yongyaoduan/comp5047-campfire-aftercare/README.md

# Campfire Aftercare — COMP5047 Group 23

Raspberry Pi vision and Bluetooth LE, FireBeetle ESP32-E two-LED control, spoken prompts, water/heat sensors, and a 12V water pump.

## Lights and speech

| Output | Meaning |
|---|---|
| Green / GPIO16 | Person detected |
| Red / GPIO17 | Fire: object temperature at least 10°C above room temperature for 1 s; off once below room + 7°C for 1 s |
| Audio / GPIO25 DAC1 | Spoken prompts and alarm |
| Pump / GPIO26 | MOSFET control signal |

**Both LEDs continue to indicate their states while spraying.** There is no LED for the heart or for a low tank: a held heart is answered by "I love you too" and, when the bowl is hot, by water; a low tank is announced by the repeating water prompt.

The committed English WAV files and flash-resident samples are generated with macOS Samantha at 100 words/minute, then high-passed, compressed to full DAC swing and played 5% slower (15.2 kHz) for a calm, loud voice (`firebeetle/audio/build_audio.py`):

- [I need some water.](firebeetle/audio/water.wav) — repeats every 5 seconds while the tank is low (fewer than the bottom 5 of the sensor's 20 sections wet, under about 25 mm) and someone is in view. A low tank does not block the pump.
- [Fire's still burning. Make a heart, I'll put it out.](firebeetle/audio/fire.wav) — once, when someone comes back during the alarm or an automatic spray.
- [I love you too.](firebeetle/audio/love.wav) — once per new heart gesture.
- [Putting the fire out.](firebeetle/audio/spray.wav) — once, when an automatic spray starts.
- [Enough water, thank you.](firebeetle/audio/full.wav) — once, when the bottom 15 of the sensor's 20 sections (75 mm) are wet, leaving headroom below the top of the 4 L tank; it can repeat only after the level has dropped below 13 sections.

Playback is offline. The WAV files and generated `AudioSamples.h` are included; macOS is needed only to regenerate them. Audio runs through I2S DMA on GPIO25 in its own task, independently of the control loop and sensor reads. An alarm interrupts speech. A due low-water warning takes priority over another spoken prompt.

## Control sequence

1. No fire: no sound, no pump; timers reset. A heart still plays "I love you too".
2. Fire with people in view is normal use: no sound, no pump.
3. **A heart works at any time.** While any visible person holds a two-hand heart and the bowl is hot, the pump runs; it stops the moment the hands drop (the BLE heart message expires 0.8 s after the last heartbeat; with the Pi 3B+ at ~1 FPS the observed stop is about 2 s after the hands actually drop).
4. Fire with nobody in view (including nobody ever seen): wait 5 s silently (shortened for the demo; a field version would wait longer). Coming back within 5 s: nothing happens.
5. Then alarm 1 s on / 1 s off, three times before the automatic spray (at most 10 bursts per episode, see step 7). Coming back during the alarm stops it and plays the fire prompt once; after that it is normal use.
6. Nobody back after the third pause (11 s from absence): "Putting the fire out", then spray until the bowl falls below room + 7°C. A person walking in without a heart stops the pump immediately.
7. Low water (fewer than 5 sections) is only spoken: with someone in view it asks for water, and the pump keeps working while any water is detected. Only an empty tank (no wet section) blocks every spray; with nobody in view the alarm then keeps calling, up to 10 bursts in all, and the automatic spray starts once water is added.
8. Re-ignition after an automatic spray restarts the cycle at step 4. Invalid/stale sensor readings, BLE disconnect, stale command stream, or STOP block spraying and reset the sequence.

Room temperature is the mean IR object reading over the first 10 s after power-up (restarted if the readings spread by more than 2°C), so keep anything warm away from the IR window at start-up. Fire detection uses hysteresis (on at room + 10°C, off below room + 7°C, each held for 1 s) so the pump does not chatter around one threshold. **Start-up standby:** for about 10 s the station does nothing and both LEDs blink; once the thermometer is calibrated and the water sensor answers, the blinking stops. Put the water-level sensor in the tank only after the blinking stops. A fast-flickering red LED after 30 s means a sensor is not answering. The Pi always looks for at least four hands, so any visible person's heart counts even with `--max-people 1`.

Temperature and water are sampled in a separate task roughly every 250 ms, so cooling is checked more frequently than the report's 5-second requirement. The water threshold is the reference raw value >100; two valid samples settle wet/dry. Isolated upper drops are ignored for height, but a film on the bottom segment can still look like water. Water-height precision is not 100 ms: that is a diagnostic polling interval, not measurement accuracy.

## Circuit

The report's existing drawing and visual layout are included unchanged:

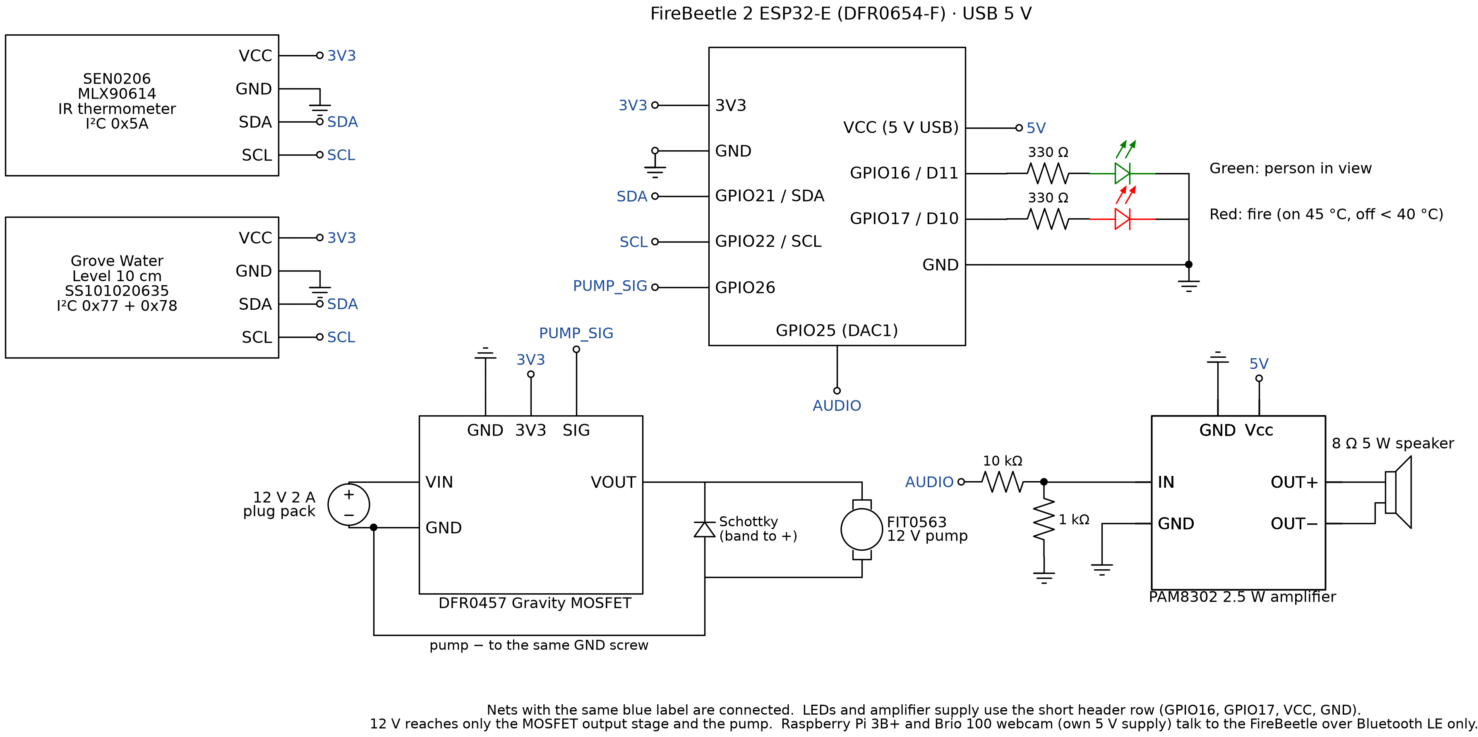
[picture p1: img/schematic.png]
Circuit schematic


[SVG schematic](img/schematic.svg) · [System diagram](img/circuit.svg) · [Drawing source](schematic.py)

| Connection | Wiring |
|---|---|
| Each LED | GPIO16 (green) / GPIO17 (red), on the short header row → its own 330Ω resistor → anode; cathode → GND on the same row |
| Water sensor | White SDA→21, yellow SCL→22, red→3V3, black→GND |
| IR thermometer | SDA→21, SCL→22, VCC→3V3, GND→GND; use module labels |
| DFR0457 control plug | Signal→26, VCC→3V3, GND→GND |
| DFR0457 screw terminals | Supply +12V→VIN; supply negative and pump negative→GND; pump positive→VOUT |
| Flyback diode | Across pump; striped cathode→pump positive, anode→pump negative |
| Makerverse CE08263 audio | GPIO25→10kΩ→IN; IN→1kΩ→GND; both amplifier GND pins→board GND; SD left open |
| Amplifier supply | Board VCC (5V from USB) and GND on the short header row; begin at low volume |
| Speaker | Both leads to amplifier output +/−; neither lead to GND |

The drawing uses functional input/output labels rather than literal terminal counts. The actual DFR0457 has three power screw terminals, **VIN/GND/VOUT**. Makerverse CE08263 has **IN, signal GND, SD, Vcc, power GND**; its signal GND corresponds to the drawing's grounded input reference. Match the labels on the actual modules.

12V powers only the pump circuit; never connect it to the FireBeetle, Pi or amplifier. The Pi/webcam use their own 5V supply; FireBeetle uses USB power. Keep the existing sensor and pump wires. GPIO25 is reserved for audio.

## Repository layout

- `pi/`: USB camera processing, person/heart recognition, latest-frame capture and BLE client.
- `firebeetle/`: two-LED/voice firmware, state machine, sensor readers, audio clips and C++ tests.
- `mac-backup/`: demo-day fallback — Swift/Apple Vision app for a MacBook that replaces the Pi's vision step and sends the same BLE commands (see `mac-backup/README.md`).
- `hardware-tests/`: standalone diagnostic programs, including 100 ms raw water logging.
- `cad/`: enclosure source scripts and schedules.
- `schematic.py`, `img/`: report circuit diagram and generator.

CAD files are historical design iterations, not an endorsement of every part as fabrication-ready; the older full-print bracket alignment issue is recorded in `cad/campfire-simple-v3/ASSEMBLY_STATUS.txt`. Downloaded model weights and build caches are excluded. Some optional photo/benchmark scripts need locally supplied inputs.

## Raspberry Pi setup

Tested dependency target: Pi 3B+, 64-bit OS, Python 3.11.

```bash
cd pi
python3.11 -m venv .venv
source .venv/bin/activate
python -m pip install -r requirements-pi3.txt
python download_models.py
python app.py --profile pi3 --max-people 1
```

Model downloads are versioned and SHA-256 checked. The USB webcam must be connected to the Pi. The BLE peripheral advertises `Campfire-FireBeetle`. Inference speed and supply stability must be checked on the actual Pi; simulation tests do not verify live camera or BLE operation.

### Start on boot

`pi/campfire.service` is a systemd user service (no sudo needed). On the Pi: `mkdir -p ~/.config/systemd/user && cp ~/gesture-pump/campfire.service ~/.config/systemd/user/`, `loginctl enable-linger "$USER"`, then `systemctl --user daemon-reload && systemctl --user enable --now campfire`. It runs `app.py --profile pi3 --max-people 1` about 20 s after every power-up and restarts it if it stops (`journalctl --user -u campfire -f` for logs; `systemctl --user stop campfire` before a manual run).

## FireBeetle build and upload

Install PlatformIO, connect FireBeetle 2 ESP32-E, then:

```bash
pio run -d firebeetle
pio device list
pio run -d firebeetle -t upload --upload-port YOUR_SERIAL_PORT
pio device monitor --port YOUR_SERIAL_PORT --baud 115200
```

BLE accepts raw one-byte values: `0` absent, `1` present, `4` heart held, `5` heart released, `6` STOP. USB serial accepts those ASCII digits. USB commands expire unless refreshed; the Pi refreshes commands automatically. Serial `w`, `f`, `l`, `p` tests the four voice clips without intentionally enabling the pump.

The physical pump requires a MOSFET module and independent 12V supply. Diagnostic GPIO26 blink/wiring programs can activate the attached pump; use the appropriate firmware for the connected hardware.

## Tests

```bash
(cd pi && python3 -m unittest discover -s tests -p 'test_*.py')
c++ -std=c++11 firebeetle/tests/control_test.cpp -o /tmp/campfire-control-test
/tmp/campfire-control-test
pio run -d firebeetle
```

Tests cover LED states during pumping, heart-held spraying, absent-person timing, return cancellation, dry/unknown-water lockout, cooling, communication loss, time wraparound, and camera/gesture policies. They do not constitute a physical water-flow, acoustic clarity, or end-to-end hardware test. This two-LED/voice build has been compiled and simulation-tested, and has not been uploaded to the physical board in this session.

## Regenerate diagrams or speech

```bash
python3 -m pip install -r requirements-diagram.txt
python3 schematic.py
# macOS only; bundled WAV/header files are already usable elsewhere:
python3 firebeetle/audio/build_audio.py
```

The generator writes beside itself regardless of the current working directory. The original report file is not modified.

## References

[FireBeetle](https://wiki.dfrobot.com/dfr0654/) · [MOSFET](https://wiki.dfrobot.com/dfr0457) · [Makerverse amplifier](https://core-electronics.com.au/makerverse-pam8302-2-5w-mono-amplifier.html) · [Water sensor](https://wiki.seeedstudio.com/Grove-Water-Level-Sensor/)

This is a supervised classroom prototype, not a validated fire-extinguishing device.

## Water level sensor: power up dry

The Grove water-level sensor calibrates itself when it is powered. Powered up while
its pads are in water, it reports every pad as 0 (I²C still works), so the station
believes the tank is empty and keeps asking for water. Always power the station with
the sensor out of the water (or before filling), then fill. If it restarted in water:
unplug the 12 V pump, lift the sensor out, wipe it, power-cycle, put it back.
The firmware treats a sudden drop from a real level to all-zero as a sensor fault
(no water request, no spray) until real readings return; serial `r` prints the pads.
