yongyaoduan/comp5047-campfire-aftercare/cad/blender-built-enclosure/renders_woodwork_and_leaf.png

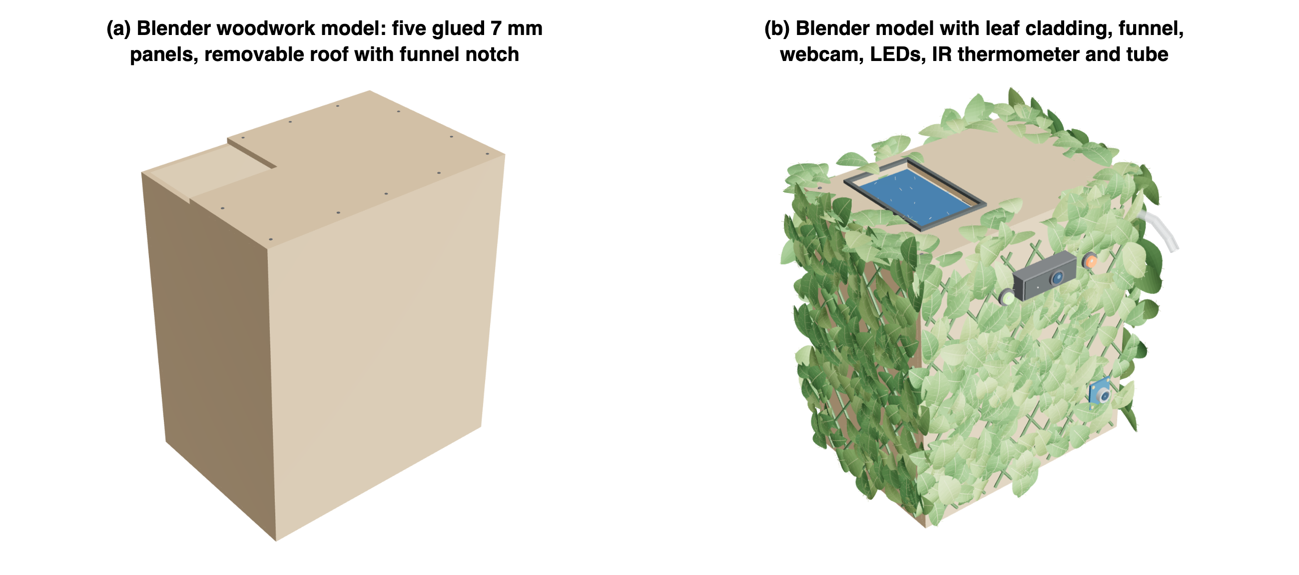
cad/blender-built-enclosure/renders_woodwork_and_leaf.png
