yongyaoduan/comp5047-campfire-aftercare/cad/campfire-simple-v3/parts.csv

name | quantity | x | y | z | volume_cm3
base_1 | 1 | 165.0 | 230.0 | 3.0 | 113.74
base_2 | 1 | 165.0 | 230.0 | 3.0 | 113.74
roof_1 | 1 | 165.0 | 230.0 | 3.0 | 100.67
roof_2 | 1 | 165.0 | 230.0 | 3.0 | 41.68
front_band1_1 | 1 | 164.8 | 189.6 | 3.0 | 93.6
front_band1_2 | 1 | 164.8 | 189.6 | 3.0 | 93.6
back_band1_1 | 1 | 164.8 | 189.6 | 3.0 | 93.6
back_band1_2 | 1 | 164.8 | 189.6 | 3.0 | 93.6
left_band1 | 1 | 223.6 | 189.6 | 3.0 | 127.05
right_band1 | 1 | 223.6 | 189.6 | 3.0 | 127.05
front_band2_1 | 1 | 164.8 | 186.6 | 3.0 | 92.12
front_band2_2 | 1 | 164.8 | 186.6 | 3.0 | 92.12
back_band2_1 | 1 | 164.8 | 186.6 | 3.0 | 92.12
back_band2_2 | 1 | 164.8 | 186.6 | 3.0 | 92.12
left_band2 | 1 | 223.6 | 186.6 | 3.0 | 125.04
right_band2 | 1 | 223.6 | 186.6 | 3.0 | 125.04
funnel_rim_adapter_ID172_OD210_PROVISIONAL | 1 | 210.0 | 209.93 | 6.0 | 68.16
M3_corner_bracket | 24 | 24.0 | 24.0 | 24.0 | 3.19
seam_strap | 12 | 64.0 | 20.0 | 3.0 | 3.79
M3_fit_coupon | 1 | 30.0 | 30.0 | 3.0 | 2.67
