yongyaoduan/comp5047-campfire-aftercare/cad/campfire-simple-v3/ASSEMBLY_STATUS.txt

V3 full-print assembly is NOT fabrication-verified. Corner bracket/panel hole offsets were found during assembly audit. See ../campfire-wood-assembly-v4/ for the revised plywood assembly. Do not treat V3 mesh checks as proof of assembly fit.
