yongyaoduan/comp5047-campfire-aftercare/(commit log)

2026-11-04 Implement four LED and spoken-prompt controller with Pi vision and circuit diagrams
    [7mm_cut_list.csv, assembly_drilling.csv, cut_list.csv, dimension_summary.csv, parts.csv, wood_cut_list.csv]
2026-11-04 Update control rules: heart-held spraying, unattended alarm, hysteresis
    - Heart spray works at any time and runs only while the heart is held
    - Unattended: 20 s silent grace, up to three 5 s alarm bursts, then auto spray;
    a person walking in without a heart stops the pump immediately
    - Returning during the grace period does nothing; returning during the alarm
    plays the fire prompt once
    - Low water blocks every spray but keeps the alarm sounding when nobody is near
    - Fire detection hysteresis: on at 45 C, off below 40 C
    - New voice clips: "I need some water", "I love you too", "Putting the fire out"
    - Pi hand model always looks for at least four hands so any visible person's
    heart count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
2026-11-04 Add Mac vision backup for demo day
    Swift/Apple Vision fallback adapted from the October Mac prototype to the
    final FireBeetle protocol: presence re-sent every second, two-hand heart
    only, waves not sent.
2026-11-04 Swap LED meanings: yellow = heart, blue = tank low
    Wiring is unchanged (yellow GPIO13, blue GPIO4); only the state each LED
    shows is swapped. Schematic also corrected: DFR0457 has three screw
    terminals (VIN, GND, VOUT; pump - shares the GND screw) and the Makerverse
    PAM8302 input is single-ended (IN / GND). Control tests pass.
    [ControlState.h, FireBeetleBLE.ino, schematic.py]
2026-11-05 Two LEDs on the short header row; amplifier on 5 V
    Drop the blue (tank low) and yellow (heart) LEDs: the repeating water
    prompt and the "I love you too" reply already cover them. Green moves
    to GPIO16 and red to GPIO17 on the free short header row; the PAM8302
    is powered from the board's VCC (5 V USB) pin. Firmware, tests,
    schematic, README and Mac backup text updated.
    [ControlState.h, FireBeetleBLE.ino, schematic.py]
2026-11-05 Relax the pi3 freshness limit for a heart from 1.2 s to 2 s
    A Pi 3B+ on a weak supply took 1.2-1.3 s per frame, so every heart
    result was too old and the pump never started. Two consecutive heart
    frames are still required and one negative frame still revokes at once.
    Timing tests rescaled; new test for 1.3 s frames.
2026-11-05 Demo timing: 5 s silent wait, alarm 1 s on / 1 s off x3
    Shortened so the whole unattended sequence fits a short demo; automatic
    spray now starts 11 s after the station decides nobody is in view.
    [ControlState.h]
2026-11-05 Fix audio: APLL clock (DAC ran 5.5x fast), louder and slower prompts, shorter fire line
    - use_apll: measured 88.6k samples/s for a 16 kHz setting without it; 16.1k with it
    - build_audio.py: high-pass 300 Hz, soft limiter, full 8-bit swing; say -r 100, play at 15.2 kHz
    - alarm tone: 880 Hz clipped sine at full swing
    - fire prompt: "Fire's still burning. Make a heart, I'll put it out."
    [AudioPlayer.h]
2026-11-05 Tank low below 2 wet sections (10 mm) instead of 1
    Keeps the pump intake under water; tests cover 1 vs 2 sections.
2026-11-05 Laptop (Apple Vision) program becomes the vision host; photo regression tool
    - VisionPipeline.swift shared by the live app and Tools/PhotoRegression.swift
    - presence: full-body box OR face OR visible hand, animals removed; any number of people
    - heart: any pair of up to 8 hands, landmarks from 0.2, opening 0.45-1.8 palms (as on the Pi),
    second look in person regions and three tiles
    - 2 s camera/vision stall -> STOP; external webcam preferred, built-in as fallback
    - verify.sh: heart unit tests + builds; 264-photo regression: people 128/139, false person 3/125,
    hearts 52/73, false heart 0/190, 21 ms/frame median
2026-11-05 Laptop program: 2 s confirmation for person and heart, 1 s heart release, 2 s absence
    PresenceFilter and HeartDetector use time windows with small gap tolerance; unit tests cover
    start, release, short and long misses and a flickering false detection. Regression replays each
    photo for 3 s through the same filters (counts unchanged: people 128/139, hearts 52/73, 0 false hearts).
2026-11-05 Water film guard: sudden all-dry reading is 'unknown' for 10 s; 'r' prints raw pads
    A water film over the Grove pads made every pad read 0 while the tank held water (5 Nov).
    Real water cannot drop from >=15 mm to nothing in one step, so such a reading neither says
    'I need some water' nor allows spraying for 10 s. Serial 'r' toggles raw pad values.
    Control tests: 12 groups pass.
2026-11-05 Water sensor: sudden all-zero reading is a persistent fault, not 'low'; README: power up dry
    Root cause found on 5 Nov: the Grove sensor calibrates at power-up and reads all zeros if
    powered in water. A sudden fall from >=15 mm to nothing now blocks spraying and silences the
    water request until real readings return (no 10 s auto-accept). Tests: 12 groups pass.
2026-11-06 CAD v3 README in English; mark v3 as historical (final build is the v4 plywood box)
2026-11-06 Fire threshold relative to room: calibrate first 10 s, hot at room+10 C for 1 s, clear below room+7 C; 30 s start-up standby with double blink
2026-11-06 Standby 10 s with both LEDs blinking throughout; blinking stops when ready (fault flicker after 30 s)
2026-11-06 Water: ask for water below 5 sections, block pump only when empty; cap alarm at 10 bursts
    - "I need some water" now repeats while fewer than 5 of 20 sensor sections are wet (was 2).
    - A low tank no longer blocks the pump: heart and automatic sprays run while any water is detected; only an empty tank (no wet section) blocks them.
    - Unattended alarm: at most 10 bursts per episode (3 before the automatic spray; with an empty tank it keeps calling up to the cap, then stops; spraying still starts once water is added).
    - Serial status line adds empty=; host tests cover the new rules (14 scenario groups).
    [ControlState.h, FireBeetleBLE.ino, WaterLevelState.h]
2026-11-06 Add Charan's Blender models of the built enclosure (woodwork and leaf cladding)
